jcarrete5/lufa/README.md

# Rock Band 3 MIDI Adapter
Adapts a MIDI input to a RB3 drum kit.

## Build Dependencies
- [Mako](https://www.makotemplates.org/download.html) - a python templating solution
