jcarrete5/lufa/pcb/rb3-midi-adapter-design.kicad_pcb

## KiCad design pcb/rb3-midi-adapter-design.kicad_pcb (2024-05-17)

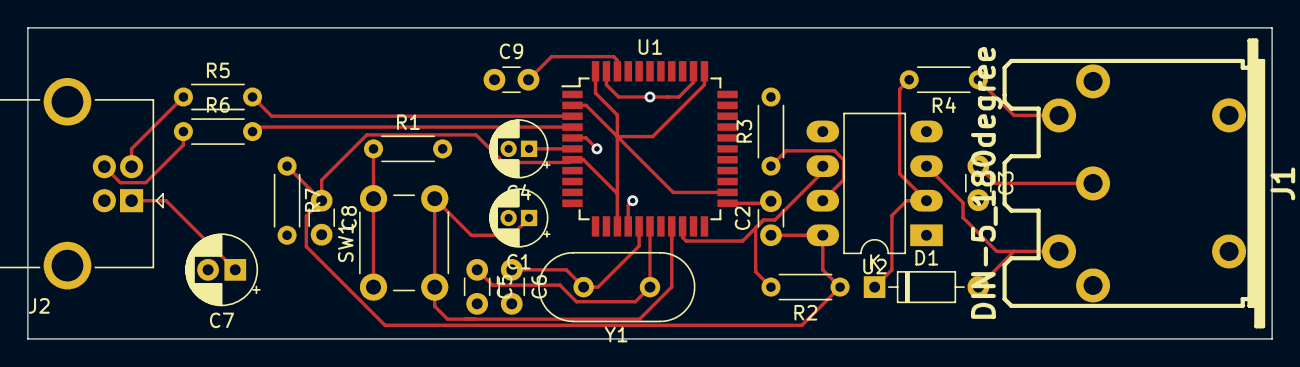
[picture p1: board rb3-midi-adapter-design.kicad_pcb from above]

Board: 2 copper layers, 91.4 x 22.9 mm, 23 parts (0 on the bottom side), 19 nets.

Parts:
C1, C4: 1u; CP_Radial_D4.0mm_P1.50mm
C2, C3, C8, C9: 100n; C_Disc_D3.0mm_W1.6mm_P2.50mm
C5, C6: 22p; C_Disc_D3.0mm_W1.6mm_P2.50mm
C7: 22u; CP_Radial_D5.0mm_P2.00mm
D1: 1N4148; D_DO-35_SOD27_P7.62mm_Horizontal
J1: DIN-5_180degree; MIDI_DIN5
J2: USB_B; USB_B_OST_USB-B1HSxx_Horizontal
R1, R2: 1k; R_Axial_DIN0204_L3.6mm_D1.6mm_P5.08mm_Horizontal
R3, R7: 10k; R_Axial_DIN0204_L3.6mm_D1.6mm_P5.08mm_Horizontal
R4: 220; R_Axial_DIN0204_L3.6mm_D1.6mm_P5.08mm_Horizontal
R5, R6: 22; R_Axial_DIN0204_L3.6mm_D1.6mm_P5.08mm_Horizontal
SW1: SW_Push; SW_PUSH_6mm_H8mm
U1: ATmega32U4-MU; TQFP-44_10x10mm_P0.8mm
U2: 6N138; DIP-8_W7.62mm_LongPads
Y1: 16MHz; Crystal_HC49-4H_Vertical

Connections:
+5V: C2.1, C8.1, R2.1, R7.1, U1.2, U1.7, U1.14, U1.24, U1.34, U1.44, U2.8
/RX: R2.2, U1.20, U2.6
/START_BTN: C1.1, SW1.2, U1.19
GND: C1.2, C2.2, C3.2, C4.2, C5.2, C6.2, C7.2, C8.2, C9.1, J2.4, J2.5, R1.2, R3.2, R7.2, U1.5, U1.15, U1.23, U1.35, U1.43, U2.5
unnamed: C3.1, J1.2
unnamed: C4.1, U1.6
unnamed: C5.1, U1.17, Y1.1
unnamed: C6.1, U1.16, Y1.2
unnamed: C7.1, J2.1
unnamed: C9.2, U1.42
unnamed: D1.1, R4.2, U2.2
unnamed: D1.2, J1.5, U2.3
unnamed: J1.4, R4.1
unnamed: J2.2, R5.1
unnamed: J2.3, R6.1
unnamed: R1.1, SW1.1
unnamed: R3.1, U2.7
unnamed: R5.2, U1.3
unnamed: R6.2, U1.4
