jcarrete5/lufa/(commit log)

2021-10-23 Track state as MIDI notes are received
2021-11-06 Start work on adapter schematics and PCB
    [rb3-midi-adapter-design.sch]
2022-05-04 Update KiCad project files to latest version
    [rb3-midi-adapter-design.kicad_pcb, rb3-midi-adapter-design.kicad_sch, rb3-midi-adapter-design.sch]
2022-05-04 Rename rb3-midi-adapter-design -> kicad
    [rb3-midi-adapter-design.kicad_pcb, rb3-midi-adapter-design.kicad_sch]
2022-05-09 Rename kicad/ -> pcb/
    [rb3-midi-adapter-design.kicad_pcb, rb3-midi-adapter-design.kicad_sch]
2022-05-09 Set bcdDevice to version 2.0
    The normal RB3 adapter uses this version so I should probably use it too
    to avoid the PS3 possibly choosing an incorrect driver for the adapter
    [Descriptors.c]
2022-07-12 Fix include in MIDI.c
    [MIDI.c]
2023-01-31 Minor formatting and type fixes
    [MIDI.c, rb3-midi-adapter.c]
2023-01-31 Update schematic
    [rb3-midi-adapter-design.kicad_sch]
2024-05-17 Migrate kicad to 8.0
    [rb3-midi-adapter-design.kicad_pcb, rb3-midi-adapter-design.kicad_sch]
2024-07-02 Update kicad_pro
2024-07-02 Declare midi buffer data and count volatile
    These fields may be accessed from both inside and outside an ISR and
    should be declared volatile to prevent the compiler from optimizing away
    accesses to that data.
    [MIDI.c]
2024-07-08 Fix includes and warnings in HIDReport.c
    [HIDReport.c]
2024-07-08 Remove prev hid_report
    This avoids wasting time comparing HID reports. Instead, HID reports are
    always sent regardless if they are the exact same. Sometimes they will
    be the same and that's okay. The original rb3 drum kit does this too.
    [rb3-midi-adapter.c]
